algesten/sil/sil.kicad_pcb

## KiCad design sil.kicad_pcb (2022-02-04)

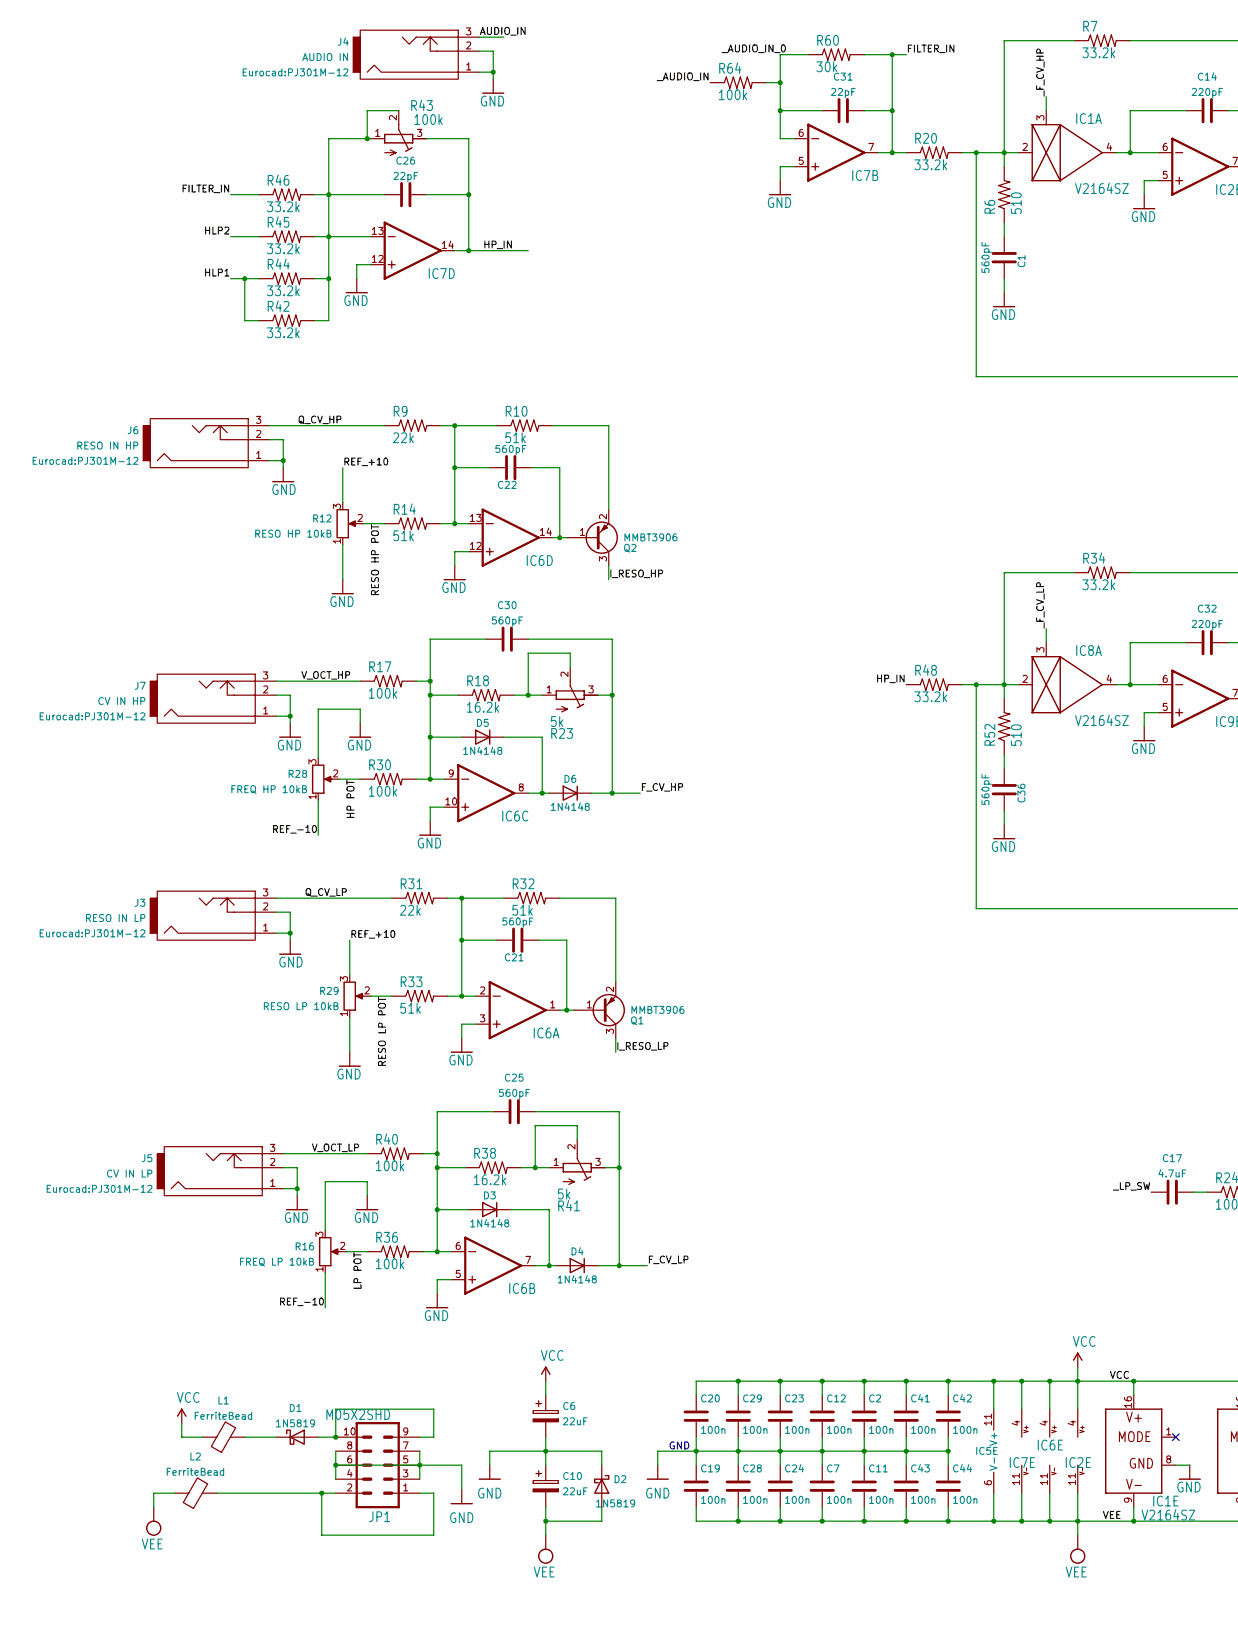
[picture p1: schematic sil.kicad_sch, part in row 1, column 1]

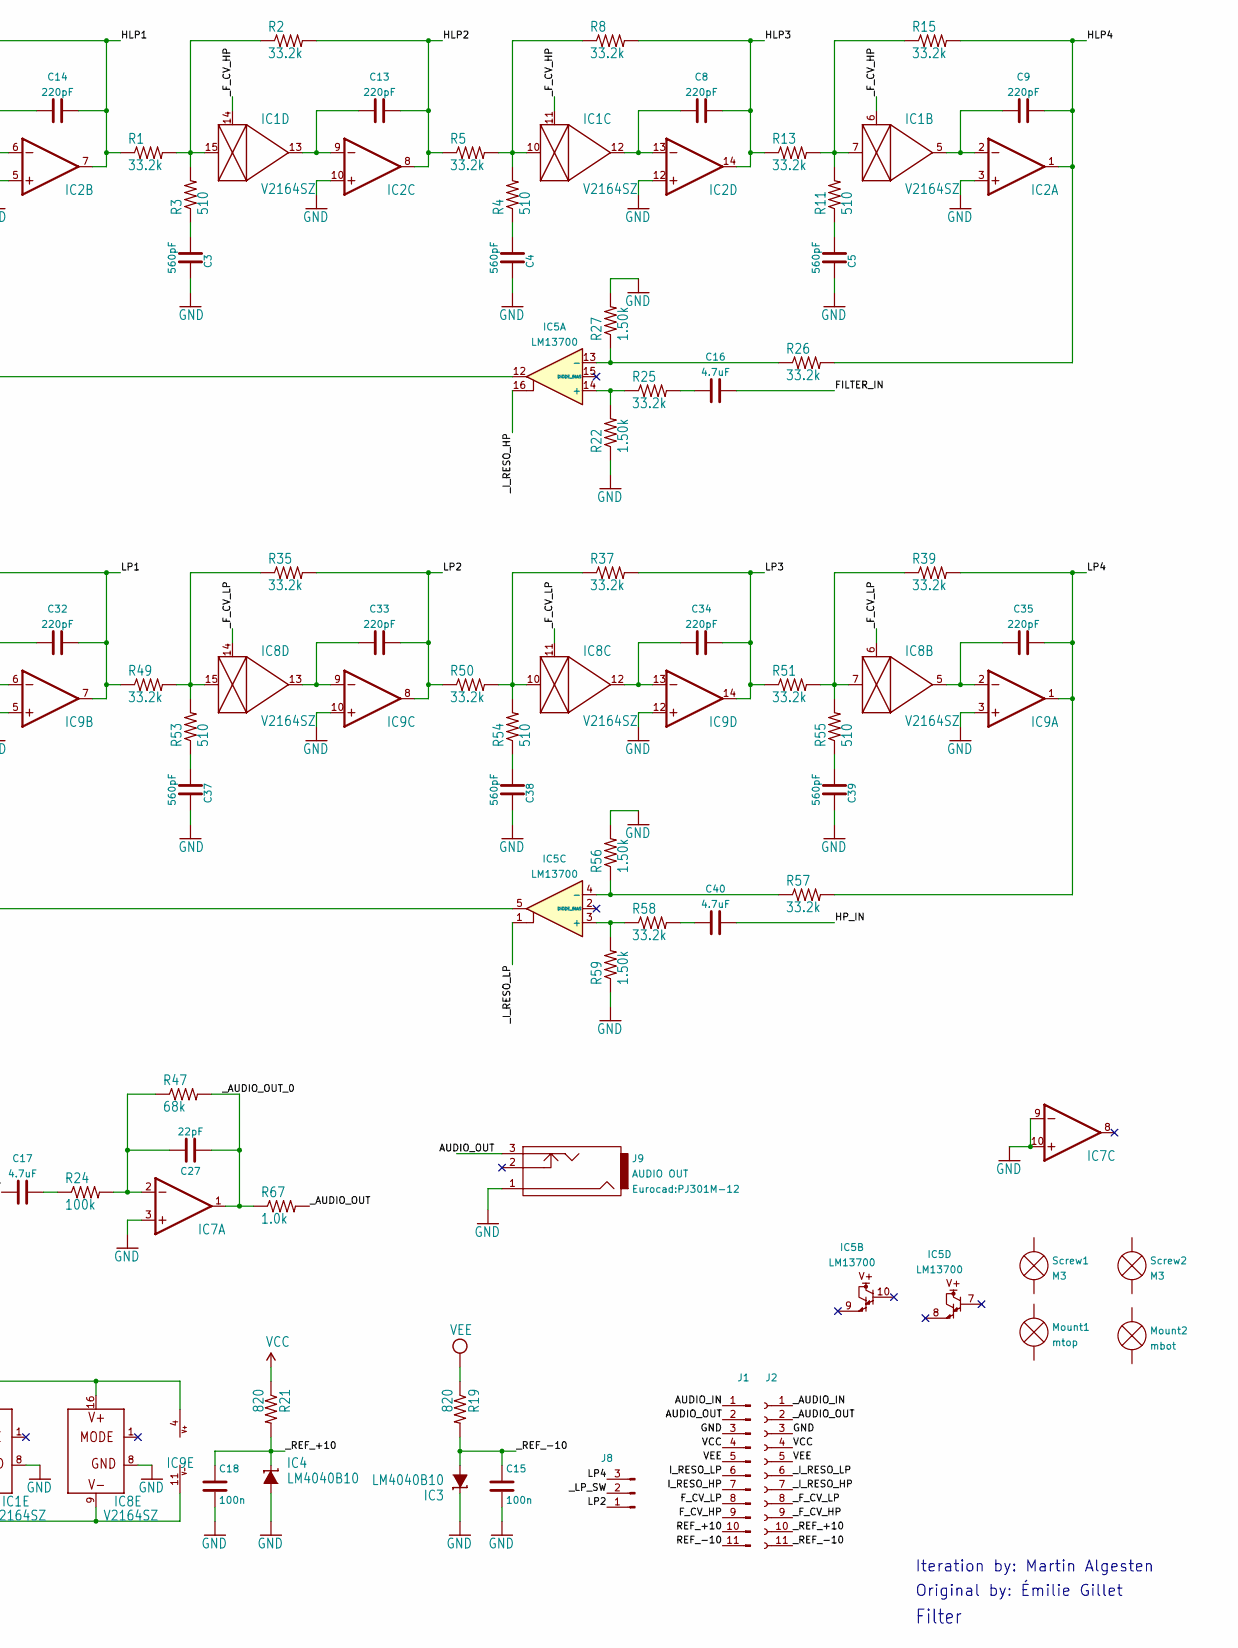
[picture p2: schematic sil.kicad_sch, part in row 1, column 2]

Parts:
C1, C3, C4, C5, C21, C22, C25, C30, C36, C37, C38, C39: 560pF; C_0402_1005Metric; LCSC C318606
C2, C7, C11, C12, C15, C18, C19, C20, C23, C24, C28, C29, C41, C42, C43, C44: 100n; C_0402_1005Metric; LCSC C105882
C6, C10: 22uF; CP_Elec_5x5.4; LCSC C239256
C8, C9, C13, C14, C32, C33, C34, C35: 220pF; R_0603_1608Metric; LCSC C302060
C16, C40: 4.7uF; C_1206_3216Metric; LCSC C7237
C17: 4.7uF; R_1206_3216Metric; LCSC C318753
C26, C27, C31: 22pF; C_0402_1005Metric; LCSC C1555
D1, D2: 1N5819; D_SOD-123; LCSC C2905649
D3, D4, D5, D6: 1N4148; D_SOD-523; LCSC C68948
IC1, IC8: V2164SZ; SOIC-16_4.55x10.3mm_P1.27mm
IC2, IC7, IC9: OPA1679; TSSOP-14_4.4x5mm_P0.65mm
IC3, IC4: LM4040B10; SOT-23; LCSC C201738
IC5: LM13700; SOIC-16_3.9x9.9mm_P1.27mm
IC6: TL074; TSSOP-14_4.4x5mm_P0.65mm
J1: Conn_01x11_Male; PinHeader_1x11_P2.54mm_Vertical
J2: Conn_01x08_Female; PinSocket_1x11_P2.54mm_Vertical
J3: RESO IN LP; PJ301M-12
J4: AUDIO IN; PJ301M-12
J5: CV IN LP; PJ301M-12
J6: RESO IN HP; PJ301M-12
J7: CV IN HP; PJ301M-12
J8: Conn_01x03_Male; PinHeader_1x03_P2.54mm_Vertical
J9: AUDIO OUT; PJ301M-12
JP1: M05X2SHD; Power_small
L1, L2: FerriteBead; R_0402_1005Metric; LCSC C76883
Mount1: mtop; Mounting hole
Mount2: mbot; Mounting hole
Q1, Q2: MMBT3906; SOT-523; LCSC C2828444
R1, R2, R5, R7, R8, R13, R15, R20, R25, R26, R34, R35, R37, R39, R42, R44, R45, R46, R48, R49, R50, R51, R57, R58: 33.2k; R_0402_1005Metric; LCSC C2692992
R3, R4, R6, R11, R52, R53, R54, R55: 510; R_0402_1005Metric; LCSC C25123
R9, R31: 22k; R_0402_1005Metric; LCSC C25768
R10, R14, R32, R33: 51k; R_0402_1005Metric; LCSC C25794
R12: RESO HP 10kB; Alpha9mmPot
R16: FREQ LP 10kB; Alpha9mmPot
R17, R24, R30, R36, R40, R64: 100k; R_0402_1005Metric; LCSC C25741
R18, R38: 16.2k; R_0402_1005Metric; LCSC C27176
R19, R21: 820; R_0402_1005Metric; LCSC C227240
R22, R27, R56, R59: 1.50k; R_0402_1005Metric; LCSC C2692761
R23, R41: 5k; bourns trimpot
R28: FREQ HP 10kB; Alpha9mmPot
R29: RESO LP 10kB; Alpha9mmPot
R43: 100k; bourns trimpot
R47: 68k; R_0402_1005Metric; LCSC C36871
R60: 30k; R_0402_1005Metric; LCSC C25776
R67: 1.0k; R_0603_1608Metric; LCSC C21190
Screw1, Screw2: M3; M3 Screw

Connections:
/AUDIO_IN: J1.1, J4.3
/AUDIO_OUT: J1.2, J9.3
/FILTER_IN: C16.2, C31.2, IC7.7 (OUT), R20.1, R46.1, R60.2
/F_CV_HP: C30.2, D6.1 (K), J1.9, R23.3 (A)
/F_CV_LP: C25.2, D4.1 (K), J1.8, R41.3 (A)
/HLP1: C14.2, IC2.7 (OUT), R1.1, R7.2, R42.1, R44.1
/HLP2: C13.2, IC2.8 (OUT), R2.2, R5.1, R45.1
/HLP3: C8.2, IC2.14 (OUT), R8.2, R13.1
/HLP4: C9.2, IC2.1 (OUT), R15.2, R26.2
/HP POT: R28.2, R30.1
/HP_IN: C26.2, C40.2, IC7.14 (OUT), R43.3 (A), R48.1
/I_RESO_HP: J1.7, Q2.3 (C)
/I_RESO_LP: J1.6, Q1.3 (C)
/LP1: C32.2, IC9.7 (OUT), R34.2, R49.1
/LP2: C33.2, IC9.8 (OUT), J8.1, R35.2, R50.1
/LP3: C34.2, IC9.14 (OUT), R37.2, R51.1
/LP4: C35.2, IC9.1 (OUT), J8.3, R39.2, R57.2
/LP POT: R16.2, R36.1
/Q_CV_HP: J6.3, R9.1
/Q_CV_LP: J3.3, R31.1
/REF_+10: J1.10, R12.3, R29.3
/REF_-10: J1.11, R16.1, R28.1
/RESO HP POT: R12.2, R14.1
/RESO LP POT: R29.2, R33.1
/V_OCT_HP: J7.3, R17.1
/V_OCT_LP: J5.3, R40.1
/_AUDIO_IN: J2.1, R64.1
/_AUDIO_IN_0: C31.1, IC7.6 (-IN), R60.1, R64.2
/_AUDIO_OUT: J2.2, R67.2
/_AUDIO_OUT_0: C27.2, IC7.1 (OUT), R47.2, R67.1
/_F_CV_HP: IC1.3 (CTRL), IC1.6 (CTRL), IC1.11 (CTRL), IC1.14 (CTRL), J2.9
/_F_CV_LP: IC8.3 (CTRL), IC8.6 (CTRL), IC8.11 (CTRL), IC8.14 (CTRL), J2.8
/_I_RESO_HP: IC5.16, J2.7
/_I_RESO_LP: IC5.1, J2.6
/_LP_SW: C17.1, J8.2
/_REF_+10: C18.1, IC4.1 (C), J2.10, R21.2
/_REF_-10: C15.1, IC3.2 (A), J2.11, R19.2
GND: C1.2, C2.2, C3.2, C4.2, C5.2, C6.2, C7.1, C10.1, C11.1, C12.2, C15.2, C18.2, C19.1, C20.2, C23.2, C24.1, C28.1, C29.2, C36.2, C37.2, C38.2, C39.2, C41.2, C42.2, C43.1, C44.1, D2.1 (K), IC1.8 (GND), IC2.3 (+IN), IC2.5 (+IN), IC2.10 (+IN), IC2.12 (+IN), IC3.1 (C), IC4.2 (A), IC6.3 (+IN), IC6.5 (+IN), IC6.10 (+IN), IC6.12 (+IN), IC7.3 (+IN), IC7.5 (+IN), IC7.9 (-IN), IC7.10 (+IN), IC7.12 (+IN), IC8.8 (GND), IC9.3 (+IN), IC9.5 (+IN), IC9.10 (+IN), IC9.12 (+IN), J1.3, J2.3, J3.1, J3.2, J4.1, J4.2, J5.1, J5.2, J6.1, J6.2, J7.1, J7.2, J9.1, JP1.3, JP1.4, JP1.5, JP1.6, JP1.7, JP1.8, R12.1, R16.3, R22.1, R27.2, R28.3, R29.1, R56.2, R59.1
unnamed: C1.1, R6.1
unnamed: C3.1, R3.1
unnamed: C4.1, R4.1
unnamed: C5.1, R11.1
unnamed: C8.1, IC1.12 (OUT), IC2.13 (-IN)
unnamed: C9.1, IC1.5 (OUT), IC2.2 (-IN)
unnamed: C13.1, IC1.13 (OUT), IC2.9 (-IN)
unnamed: C14.1, IC1.4 (OUT), IC2.6 (-IN)
unnamed: C16.1, R25.2
unnamed: C17.2, R24.1
unnamed: C21.1, IC6.1 (OUT), Q1.1 (B)
unnamed: C21.2, IC6.2 (-IN), R31.2, R32.1, R33.2
unnamed: C22.1, IC6.14 (OUT), Q2.1 (B)
unnamed: C22.2, IC6.13 (-IN), R9.2, R10.1, R14.2
unnamed: C25.1, D3.2 (A), IC6.6 (-IN), R36.2, R38.1, R40.2
unnamed: C26.1, IC7.13 (-IN), R42.2, R43.1 (E), R43.2 (S), R44.2, R45.2, R46.2
unnamed: C27.1, IC7.2 (-IN), R24.2, R47.1
unnamed: C30.1, D5.2 (A), IC6.9 (-IN), R17.2, R18.1, R30.2
unnamed: C32.1, IC8.4 (OUT), IC9.6 (-IN)
unnamed: C33.1, IC8.13 (OUT), IC9.9 (-IN)
unnamed: C34.1, IC8.12 (OUT), IC9.13 (-IN)
unnamed: C35.1, IC8.5 (OUT), IC9.2 (-IN)
unnamed: C36.1, R52.1
unnamed: C37.1, R53.1
unnamed: C38.1, R54.1
unnamed: C39.1, R55.1
unnamed: C40.1, R58.2
unnamed: D1.1 (K), L1.2
unnamed: D1.2 (A), JP1.9, JP1.10
unnamed: D3.1 (K), D4.2 (A), IC6.7 (OUT)
unnamed: D5.1 (K), D6.2 (A), IC6.8 (OUT)
unnamed: IC1.2 (IN), IC5.12, R6.2, R7.1, R20.2
unnamed: IC1.7 (IN), R11.2, R13.2, R15.1
unnamed: IC1.10 (IN), R4.2, R5.2, R8.1
unnamed: IC1.15 (IN), R1.2, R2.1, R3.2
unnamed: IC5.3 (+), R58.1, R59.2
unnamed: IC5.4 (-), R56.1, R57.1
unnamed: IC5.5, IC8.2 (IN), R34.1, R48.2, R52.2
unnamed: IC5.13 (-), R26.1, R27.1
unnamed: IC5.14 (+), R22.2, R25.1
unnamed: IC8.7 (IN), R39.1, R51.2, R55.2
unnamed: IC8.10 (IN), R37.1, R50.2, R54.2
unnamed: IC8.15 (IN), R35.1, R49.2, R53.2
unnamed: JP1.1, JP1.2, L2.2
unnamed: Q1.2 (E), R32.2
unnamed: Q2.2 (E), R10.2
unnamed: R18.2, R23.1 (E), R23.2 (S)
unnamed: R38.2, R41.1 (E), R41.2 (S)
VCC: C2.1, C6.1, C12.1, C20.1, C23.1, C29.1, C41.1, C42.1, IC1.16 (V+), IC2.4 (V+), IC5.11 (V+), IC6.4 (V+), IC7.4 (V+), IC8.16 (V+), IC9.4 (V+), J1.4, J2.4, L1.1, R21.1
VEE: C7.2, C10.2, C11.2, C19.2, C24.2, C28.2, C43.2, C44.2, D2.2 (A), IC1.9 (V-), IC2.11 (V-), IC5.6 (V-), IC6.11 (V-), IC7.11 (V-), IC8.9 (V-), IC9.11 (V-), J1.5, J2.5, L2.1, R19.1

Notes on the sheet:
Filter
Original by: Émilie Gillet
Iteration by: Martin Algesten
GND

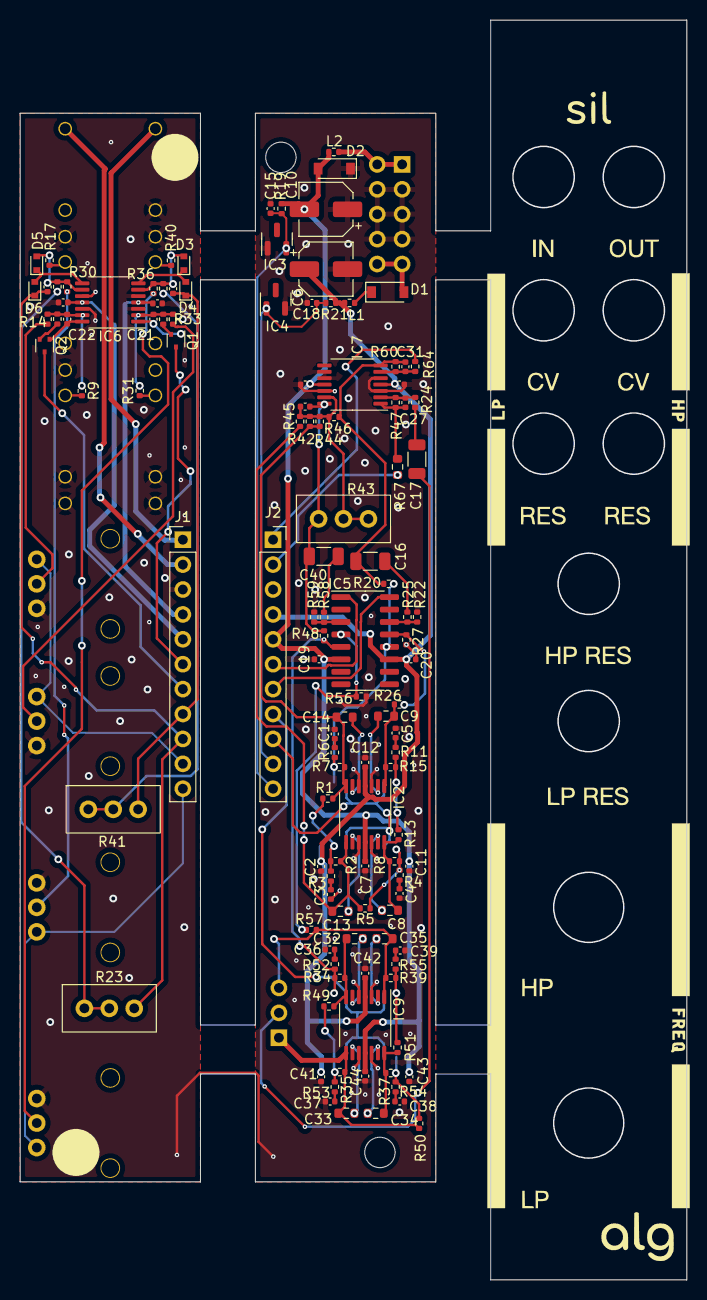
[picture p3: board sil.kicad_pcb from above]

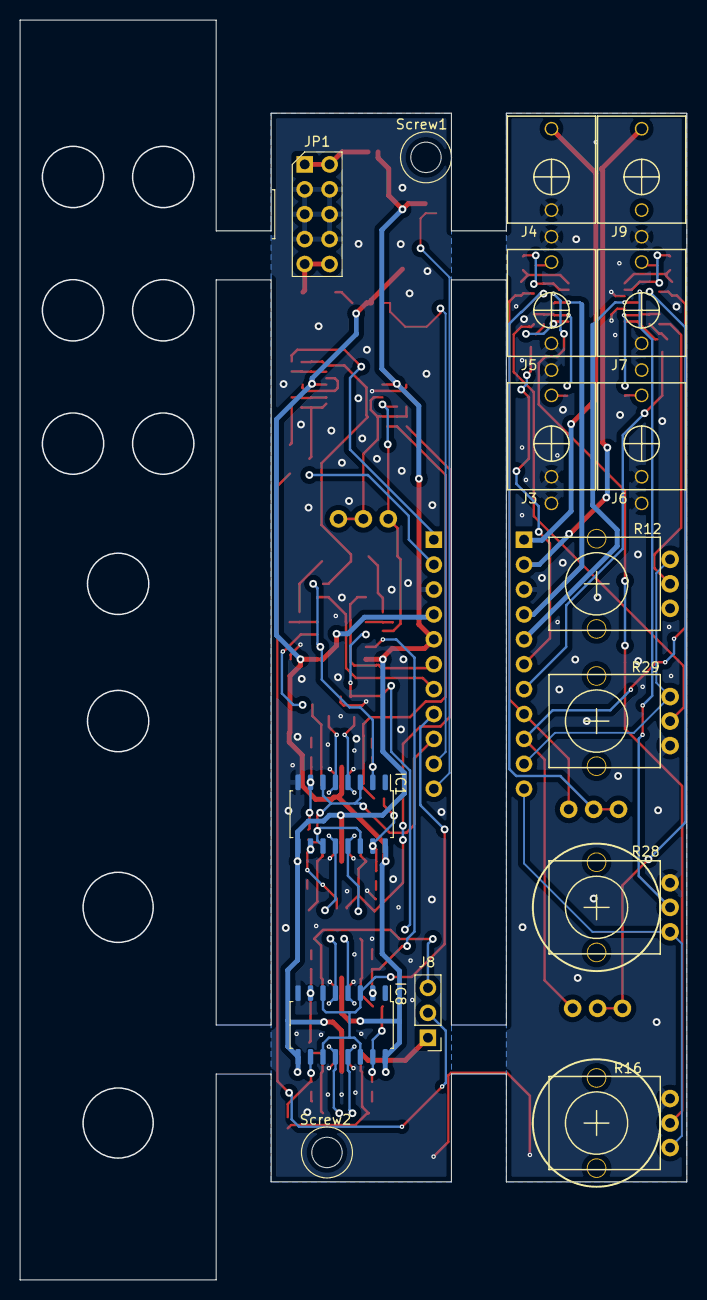
[picture p4: board sil.kicad_pcb from below]

Board: 2 copper layers, 68.0 x 128.5 mm, 139 parts (16 on the bottom side), 88 nets.
